ShamrockCircuits/KiCad_Component_DB/OPT/readme.md

OPT - Optoelectronics Component Library

Please check that your device is listed below before adding it to this library.
Check that the component type does not already exist in a different library before adding below.
Consider making an entirely new library before adding a new component type below.

__Supported Component Types__
Opto couplers, Phototransistors, ect

__Do NOT Place These Parts Here__
SSR -> See RLY
LED -> See DIO
