ShamrockCircuits/KiCad_Component_DB/libdb.xlsx

Sheet: Index
Code | Sheet | Database Table (sqlite) | Description | Row Count | LEGEND
ANA | ANA | Analog | Op-amps, Comparators, A/D, D/A | 1 | FORMULA
CAP | CAP | Capacitor | Capacitors | 26
CNT | CNT | Connector | Connectors | 7
CPD | CPD | Protection | Circuit Protection Devices (MOV, Varistor, Fuse, etc) | 0
DIO | DIO | Diode | Diodes (Zener, TVS, LED, Schottky, Standard) | 14
FAB | FAB | Fabrication | Fabrication specific elements (Fiducial, Tooling Holes, Mouse Bites) | 7
ICS | ICS | IntegratedCircuit | General Integrated Circuits | 4
IND | IND | Magnetics | Inductors, Transformers, Chokes, Magnetics | 2
MCU | MCU | Microcontroller | Microcontrollers, Modules, etc. | 1
MEC | MEC | Mechanical | Mechanical components (Mounting holes, etc) | 0
MRK | MRK | Marking | Symbols, Logos and Graphics... ie Non-BOM | 7
OPT | OPT | Optoelectronics | Optocouplers, phototransistor, SSR etc. | 0
OSC | OSC | Oscillator | Oscillators, Crystals | 0
REG | REG | Regulator | Regulators (LDO, Buck, Boost, Flyback, etc) | 2
RES | RES | Resistor | Resistors | 83
RFM | RFM | Radio | RF Modules, ICs, and Related components | 0
RLY | RLY | Relay | Relays, SSR, etc | 3
SEN | SEN | Sensor | Environmental Sensors | 0
SOC | SOC | SystemOnChip | SOC, SOM, SBC, MPU etc. | 0
SWI | SWI | Switch | All Types of Mechanical Switch | 3
TRN | TRN | Transistor | BJT, FET, IGBT | 7

Sheet: ANA
IPN | Description | FLAG - Has Basic Part | Value | Case/Package Size | Type | Symbols | Footprints | Datasheet | MFN_1 | MPN_1 | LCSC_1 | LCSC_TYPE_1 | Status_1 | MFN_2 | MPN_2 | LCSC_2 | LCSC_TYPE_2 | Status_2 | MFN_3 | MPN_3 | LCSC_3 | LCSC_TYPE_3 | Status_3 | MFN_4 | MPN_4 | LCSC_4 | LCSC_TYPE_4 | Status_4 | Comment
ANA-101-0000 | Opamp, GBWP 370kHz, RRO, 10V | FALSE | ANA1010000 | SOT23-5 | Opamp | 0-ANA:SYM-ANA-0000 | 1-PACKAGES:Generic-SOT-23-5 | https://ww1.microchip.com/downloads/en/DeviceDoc/MIC7300-High-Output-Drive-Rail-to-Rail-Op-Amp-DS20006305A.pdf | Microchip | MIC7300YM5_ | C145391 | BASIC | Candidate

Sheet: CAP
IPN | Description | FLAG - Has Basic Part | Value | Capacitance [nF] | Voltage Rating [V] | Type | Dielectric | Tolerance [%] | Case/Package Size | Symbols | Footprints | Datasheet | MFN_1 | MPN_1 | LCSC_1 | LCSC_TYPE_1 | Status_1 | MFN_2 | MPN_2 | LCSC_2 | LCSC_TYPE_2 | Status_2 | MFN_3 | MPN_3 | LCSC_3 | LCSC_TYPE_3 | Status_3 | MFN_4 | MPN_4 | LCSC_4 | LCSC_TYPE_4 | Status_4 | Comment
CAP-000-1042 | Cap Cer 100nF 50V X7R 0603 - BASIC | TRUE | 100n | 100 | 50V | Cer | X7R | 10 | 0603 | 0-CAP:SYM-CAP-0000 | 0-CAP:FTP-CAP-0001 | ~ | Samsung | CC0603KRX7R9BB104 | C14663 | BASIC | Preferred
CAP-001-1032 | Cap Cer 10nF 50V X7R 0402 - BASIC | TRUE | 10n | 10 | 50V | Cer | X7R | 10 | 0402 | 0-CAP:SYM-CAP-0000 | 0-CAP:FTP-CAP-0000 | ~ | Samsung | CL05B103KB5NNNC | C15195 | BASIC | Preferred
CAP-001-1042 | Cap Cer 100nF 50V X7R 0402 - BASIC | TRUE | 100n | 100 | 50V | Cer | X7R | 10 | 0402 | 0-CAP:SYM-CAP-0000 | 0-CAP:FTP-CAP-0000 | ~ | Samsung | CL05B104KB54PNC | C307331 | BASIC | Preferred
CAP-002-1003 | Cap Cer 10pF 50V C0G/NP0 0402 - BASIC | TRUE | 10p | 0.01 | 50V | Cer | C0G/NP0 | 5 | 0402 | 0-CAP:SYM-CAP-0000 | 0-CAP:FTP-CAP-0000 | ~ | Samsung | CL05C100JB5NNNC | C32949 | BASIC | Preferred
CAP-002-1013 | Cap Cer 100pF 50V C0G/NP0 0402 - BASIC | TRUE | 100p | 0.1 | 50V | Cer | C0G/NP0 | 5 | 0402 | 0-CAP:SYM-CAP-0000 | 0-CAP:FTP-CAP-0000 | ~ | FH | 0402CG101J500NT | C1546 | BASIC | Preferred
CAP-002-1203 | Cap Cer 12pF 50V C0G/NP0 0402 - BASIC | TRUE | 12p | 0.012 | 50V | Cer | C0G/NP0 | 5 | 0402 | 0-CAP:SYM-CAP-0000 | 0-CAP:FTP-CAP-0000 | ~ | FH | 0402CG120J500NT | C1547 | BASIC | Preferred
CAP-002-1503 | Cap Cer 15pF 50V C0G/NP0 0402 - BASIC | TRUE | 15p | 0.015 | 50V | Cer | C0G/NP0 | 5 | 0402 | 0-CAP:SYM-CAP-0000 | 0-CAP:FTP-CAP-0000 | ~ | FH | 0402CG150J500NT | C1548 | BASIC | Preferred
CAP-002-1803 | Cap Cer 18pF 50V C0G/NP0 0402 - BASIC | TRUE | 18p | 0.018 | 50V | Cer | C0G/NP0 | 5 | 0402 | 0-CAP:SYM-CAP-0000 | 0-CAP:FTP-CAP-0000 | ~ | FH | 0402CG180J500NT | C1549 | BASIC | Preferred
CAP-002-2003 | Cap Cer 20pF 50V C0G/NP0 0402 - BASIC | TRUE | 20p | 0.02 | 50V | Cer | C0G/NP0 | 5 | 0402 | 0-CAP:SYM-CAP-0000 | 0-CAP:FTP-CAP-0000 | ~ | FH | 0402CG200J500NT | C1554 | BASIC | Preferred
CAP-002-2203 | Cap Cer 22pF 50V C0G/NP0 0402 - BASIC | TRUE | 22p | 0.022 | 50V | Cer | C0G/NP0 | 5 | 0402 | 0-CAP:SYM-CAP-0000 | 0-CAP:FTP-CAP-0000 | ~ | FH | 0402CG220J500NT | C1555 | BASIC | Preferred
CAP-002-2703 | Cap Cer 27pF 50V C0G/NP0 0402 - BASIC | TRUE | 27p | 0.027 | 50V | Cer | C0G/NP0 | 5 | 0402 | 0-CAP:SYM-CAP-0000 | 0-CAP:FTP-CAP-0000 | ~ | FH | 0402CG270J500NT | C1557 | BASIC | Preferred
CAP-002-3303 | Cap Cer 33pF 50V C0G/NP0 0402 - BASIC | TRUE | 33p | 0.033 | 50V | Cer | C0G/NP0 | 5 | 0402 | 0-CAP:SYM-CAP-0000 | 0-CAP:FTP-CAP-0000 | ~ | FH | 0402CG330J500NT | C1562 | BASIC | Preferred
CAP-003-1051 | Cap Cer 1uF 50V X5R 0603 - BASIC | TRUE | 1u | 1000 | 50V | Cer | X5R | 10 | 0603 | 0-CAP:SYM-CAP-0000 | 0-CAP:FTP-CAP-0001 | ~ | Samsung | CL10A105KB8NNNC | C15849 | BASIC | Preferred
CAP-004-2261 | Cap Cer 22uF 6.3V X5R 0603 - BASIC | TRUE | 22u | 22000 | 6.3V | Cer | X5R | 20 | 0603 | 0-CAP:SYM-CAP-0000 | 0-CAP:FTP-CAP-0001 | ~ | Samsung | CL10A226MQ8NRNC | C59461 | BASIC | Preferred
CAP-005-2251 | Cap Cer 2.2uF 16V X5R 0603 - BASIC | TRUE | 2.2u | 2200 | 16V | Cer | X5R | 10 | 0603 | 0-CAP:SYM-CAP-0000 | 0-CAP:FTP-CAP-0001 | ~ | Samsung | CL10A225KO8NNNC | C23630 | BASIC | Preferred
CAP-005-4751 | Cap Cer 4.7uF 16V X5R 0603 - BASIC | TRUE | 4.7u | 4700 | 16V | Cer | X5R | 10 | 0603 | 0-CAP:SYM-CAP-0000 | 0-CAP:FTP-CAP-0001 | ~ | Samsung | CL10A475KO8NNNC | C19666 | BASIC | Preferred
CAP-006-1042 | Cap Cer 100nF 16V X7R 0402 - BASIC | TRUE | 100n | 100 | 16V | Cer | X7R | 10 | 0402 | 0-CAP:SYM-CAP-0000 | 0-CAP:FTP-CAP-0000 | ~ | Samsung | CL05B104KO5NNNC | C1525 | BASIC | Preferred
CAP-006-1061 | Cap Cer 10uF 10V X5R 0603 - BASIC | TRUE | 10u | 10000 | 10V | Cer | X5R | 10 | 0603 | 0-CAP:SYM-CAP-0000 | 0-CAP:FTP-CAP-0001 | ~ | Samsung | CL10A106KP8NNNC | C19702 | BASIC | Preferred
CAP-007-1061 | Cap Cer 10uF 25V X5R 0805 - BASIC | TRUE | 10u | 10000 | 25V | Cer | X5R | 10 | 0805 | 0-CAP:SYM-CAP-0000 | 0-CAP:FTP-CAP-0002 | ~ | Samsung | CL21A106KAYNNNE | C15850 | BASIC | Preferred
CAP-008-2261 | Cap Cer 22uF 25V X5R 0805 | FALSE | 22u | 22000 | 25V | Cer | X5R | 20 | 0805 | 0-CAP:SYM-CAP-0000 | 0-CAP:FTP-CAP-0002 | ~ | Samsung | CL21A226MAQNNNE | C45783 | BASIC | EOL |  |  |  |  |  |  |  |  |  |  |  |  |  |  |  | 11/17/2025 - CL21A226MAQNNNE updated to EOL.
CAP-009-4761 | Cap Cer 47uF 6.3V X5R 0805 - BASIC | TRUE | 47u | 47000 | 6.3V | Cer | X5R | 20 | 0805 | 0-CAP:SYM-CAP-0000 | 0-CAP:FTP-CAP-0002 | ~ | Samsung | CL21A476MQYNNNE | C16780 | BASIC | Preferred
CAP-010-1061 | Cap Cer 10uF 50V X5R 0805 - BASIC | TRUE | 10u | 10000 | 50V | Cer | X5R | 10 | 0805 | 0-CAP:SYM-CAP-0000 | 0-CAP:FTP-CAP-0002 | ~ | Murata | GRM21BR61H106KE43L | C440198 | BASIC | Preferred
CAP-010-2251 | Cap Cer 2.2uF 50V X5R 0805 - BASIC | TRUE | 2.2u | 2200 | 50V | Cer | X5R | 10 | 0805 | 0-CAP:SYM-CAP-0000 | 0-CAP:FTP-CAP-0002 | ~ | Samsung | CL21A225KBQNNNE | C377773 | BASIC | Preferred
CAP-999-0000 | PLACEHOLDER - 0402 | FALSE | TBD | TBD | TBD | Cer | N/A | ~ | 0402 | 0-CAP:SYM-CAP-0000 | 0-CAP:FTP-CAP-0000 | ~
CAP-999-0001 | PLACEHOLDER - 0603 | FALSE | TBD | TBD | TBD | Cer | N/A | ~ | 0603 | 0-CAP:SYM-CAP-0000 | 0-CAP:FTP-CAP-0001 | ~
CAP-999-0002 | PLACEHOLDER - 0805 | FALSE | TBD | TBD | TBD | Cer | N/A | ~ | 0805 | 0-CAP:SYM-CAP-0000 | 0-CAP:FTP-CAP-0002 | ~

Sheet: CNT
IPN | Description | Value | Symbols | Footprints | Datasheet | MFN_1 | MPN_1 | LCSC_1 | LCSC_TYPE_1 | Status_1 | MFN_2 | MPN_2 | LCSC_2 | LCSC_TYPE_2 | Status_2 | MFN_3 | MPN_3 | LCSC_3 | LCSC_TYPE_3 | Status_3 | MFN_4 | MPN_4 | LCSC_4 | LCSC_TYPE_4 | Status_4 | Comment
CNT-112-0000 | 1x02 Pin, Male Socket, Horz, 5.08mm | CNT1120000 | 0-CNT:SYM-CNT-0012 | 0-CNT:FTP-CNT-0000 | https://www.phoenixcontact.com/en-us/products/pcb-header-mstba-25-hc-2-g-508-1923869?type=pdf | Phoenix Contact | 1923869 | C5443585, EXT |  | Preferred
CNT-113-0000 | 1x03 Pin, Male Socket, Horz, 5.08mm | CNT1130000 | 0-CNT:SYM-CNT-0011 | 0-CNT:FTP-CNT-0001 | https://www.phoenixcontact.com/en-ca/products/pcb-header-mstba-25-hc-3-g-508-1923872 | Phoenix Contact | 1923872 | C5484355, EXT |  | Preferred
CNT-114-0000 | 1x04 Pin, Male Socket, Horz, 5.08mm | CNT1140000 | 0-CNT:SYM-CNT-0010 | 0-CNT:FTP-CNT-0002 | https://www.phoenixcontact.com/en-pc/products/pcb-header-mstba-25-hc-4-g-508-1923885 | Phoenix Contact | 1923885 | C6983854, EXT |  | Preferred
CNT-122-0000 | 1x02 Pin, Male Header, Vert, 2.54mm | CNT1220000 | 0-CNT:SYM-CNT-0001 | 0-CNT:FTP-CNT-0007 |  | Molex | 22284020 | C234182, EXT |  | Alternate
CNT-123-0000 | 1x03 Pin, Male Header, Vert, 2.54mm | CNT1230000 | 0-CNT:SYM-CNT-0002 | 0-CNT:FTP-CNT-0008 |  | Molex | 22284030 | C587036, EXT |  | Alternate
CNT-125-0000 | 1x05 Pin, Male Header, Vert, 2.54mm | CNT1250000 | 0-CNT:SYM-CNT-0003 | 0-CNT:FTP-CNT-0010 |  | Molex | 22284050 | C563741, EXT |  | Alternate
CNT-141-0000 | 1 Pin, Drill 1mm, No Component Object | CNT1410000 | 0-CNT:SYM-CNT-0013 | 0-CNT:FTP-CNT-0012 | n/a | n/a | n/a | n/a |  | Preferred

Sheet: CPD
IPN | Auto-Gen Description | Description | Value | Case/Package Size | Type | Symbols | Footprints | Datasheet | MFN_1 | MPN_1 | LCSC_1 | LCSC_TYPE_1 | Status_1 | MFN_2 | MPN_2 | LCSC_2 | LCSC_TYPE_2 | Status_2 | MFN_3 | MPN_3 | LCSC_3 | LCSC_TYPE_3 | Status_3 | MFN_4 | MPN_4 | LCSC_4 | LCSC_TYPE_4 | Status_4 | Comment

Sheet: DIO
IPN | Description | Value | Vfd @10mA [V] | DC Current [A] | Reverse Voltage [V] | Power Dissipation [W] | Case/Package Size | Type | Other... | Symbols | Footprints | Datasheet | MFN_1 | MPN_1 | LCSC_1 | LCSC_TYPE_1 | Status_1 | MFN_2 | MPN_2 | LCSC_2 | LCSC_TYPE_2 | Status_2 | MFN_3 | MPN_3 | LCSC_3 | LCSC_TYPE_3 | Status_3 | MFN_4 | MPN_4 | LCSC_4 | LCSC_TYPE_4 | Status_4 | Comment
DIO-021-0000 | DIO Standard 100VR SOT23-3 - BASIC | DIO0210000 | 0.855 | 0.125 | 100 | 0.25 | SOT23-3 | Standard |  | 0-DIO:SYM-DIO-0005 | 1-PACKAGES:Generic-SOT-23-3 | ~ | Nexperia | BAV99,215 | C2500, BASIC |  | Preferred
DIO-021-0001 | DIO Standard 100.0VR SOD-323 - BASIC | DIO0210001 | 0.855 | 0.15 | 100 | 0.2 | SOD-323 | Standard |  | 0-DIO:SYM-DIO-0004 | 0-DIO:FTP-DIO-0003 | ~ | JCST | 1N4148WS | C2128, BASIC |  | Preferred
DIO-099-9999 | TBD | DIO0999999 | ~ | ~ | ~ | ~ | ~ | Standard | ~ | 0-DIO:SYM-DIO-0004 | ~ | ~ | ~ | ~ | ~ |  | Banned
DIO-311-0000 | DIO TVS 3.3VRWM SOD-523 | DIO3110000 | ~ | ~ | 3.3 | ~ | SOD-523 | TVS | Vrwm=3.3V, Vbr=7.0V, Vhold=1.15V, Ihold=20mA, IPP=5A@8/20us, IEC61000-4-2 15kV (air & contact) | 0-DIO:SYM-DIO-0001 | 0-DIO:FTP-DIO-0002 | ~ | Onsemi | ESD8351XV2T_G | C233437, EXT |  | Preferred |  |  |  |  |  |  |  |  |  |  |  |  |  |  |  | 07/12/2025: Beware risk of latchup due to crowbar response.
DIO-321-0000 | DIO TVS 5.0VRWM SOD-123W | DIO3210000 | ~ | ~ | 5 | 200PP | SOD-123W | TVS | Vrwm=5.0V, Vbr=7.0V, IR=800uA | 0-DIO:SYM-DIO-0001 | 0-DIO:FTP-DIO-0004 | ~ | Nexperia | PTVS5V0S1UR,115 | C478011, EXT |  | Preferred | Taiwan Semiconductor | SMF5.0A |  | n/a | Alternate
DIO-321-0001 | DIO TVS 5.0VR SOD-323 | DIO3210001 | ~ | ~ | 5 | 350PP | SOD-323 | TVS | Vrwm=5.0V, Vbr=xxV, IR=10uA | 0-DIO:SYM-DIO-0001 | 0-DIO:FTP-DIO-0003 | ~ | Bourns | CDSOD323-T05S | C3699212, EXT |  | Preferred | Onsemi | SD05T3G |  | C896890 | Candidate
DIO-361-0000 | DIO BI-TVS 26.0VR DO-214AC | DIO3610000 | ~ | ~ | 26 | 400PP | DO-214AC | TVS | Bidirectional, Vrwm=28V, Vbr=28.9V @32mA, Vhold=1.15V, IPP=9.5A, 42.1V @8/20us | 0-DIO:SYM-DIO-0002 | 0-DIO:FTP-DIO-0005 | https://www.littelfuse.com/assetdocs/tvs-diodes-smaj-datasheet?assetguid=13c2a823-03b8-4d1f-9ddc-9b44670aed9d | Littlefuse | SMAJ26CA* | C148228, EXT |  | Preferred
DIO-401-0000 | DIO LED 5.0VR 0603 WHT - BASIC | WHT | 2.9 | 0.03 | 5 | 0.1 | 0603 | LED | Color=WHT | 0-DIO:SYM-DIO-0000 | 0-DIO:FTP-DIO-0000 | ~ | Hubei | KT-0603W | C2290, BASIC |  | Preferred
DIO-401-0001 | DIO LED 5.0VR 0805 WHT - BASIC | WHT | 2.9 | 0.025 | 5 | 0.08 | 0805 | LED | Color=WHT | 0-DIO:SYM-DIO-0000 | 0-DIO:FTP-DIO-0001 | ~ | Hubei | KT-0805W | C34499, BASIC |  | Preferred
DIO-411-0000 | DIO LED 5.0VR 0603 RED - BASIC | RED | 1.9 | 0.025 | 5 | 0.04 | 0603 | LED | λ=620nm, Color=RED | 0-DIO:SYM-DIO-0000 | 0-DIO:FTP-DIO-0000 | ~ | Hubei | KT-0603R | C2286, BASIC |  | Preferred
DIO-421-0001 | DIO LED 5.0VR 0805 GRN - BASIC | GRN | 2 | 0.02 | 5 | 0.04 | 0805 | LED | λ=520nm, Color=GRN | 0-DIO:SYM-DIO-0000 | 0-DIO:FTP-DIO-0001 | ~ | Hubei | KT-0805G | C2297, BASIC |  | Preferred
DIO-431-0000 | DIO LED 5.0VR 0603 BLU | BLU | 3 | 0.025 | 5 | 0.075 | 0603 | LED | λ=470nm, Color=BLU | 0-DIO:SYM-DIO-0000 | 0-DIO:FTP-DIO-0000 | ~ | Hubei | KT-0603B | C2288, EXT |  | Preferred
DIO-441-0000 | DIO LED 5.0VR 0603 YLW | YLW | 2 | 0.025 | 5 | 0.04 | 0603 | LED | λ=590nm, Color=YLW | 0-DIO:SYM-DIO-0000 | 0-DIO:FTP-DIO-0000 | ~ | Hubei | KT-0603Y | C2287, EXT |  | Preferred
DIO-441-0001 | DIO LED 5.0VR 0805 YLW - BASIC | YLW | 2 | 0.02 | 5 | 0.04 | 0805 | LED | λ=590nm, Color=YLW | 0-DIO:SYM-DIO-0000 | 0-DIO:FTP-DIO-0001 | ~ | Hubei | KT-0805Y | C2296, BASIC |  | Preferred

Sheet: FAB
IPN | Description | Value | Symbols | Footprints | Datasheet | MFN_1 | MPN_1 | LCSC_1 | LCSC_TYPE_1 | Status_1 | MFN_2 | MPN_2 | LCSC_2 | LCSC_TYPE_2 | Status_2 | MFN_3 | MPN_3 | LCSC_3 | LCSC_TYPE_3 | Status_3 | MFN_4 | MPN_4 | LCSC_4 | LCSC_TYPE_4 | Status_4 | Comment
FAB-000-0000 | SMD Solder Jumper, 0.5x1.7mm, 0.2mm gap, Open | FAB0000000 | 0-FAB:SYM-FAB-0000 | 0-FAB:FTP-FAB-0000 | ~ | ~ | ~ | ~ |  | Preferred
FAB-100-0000 | Fiducial. 1mm CU, 2mm SM, JLC | FAB0030000 | 0-FAB:SYM-FAB-0005 | 0-FAB:FTP-FAB-0005 | ~ | ~ | ~ | ~ |  | Preferred
FAB-200-0000 | Tooling Hole, 1.152mm NPTH, JLCPCB | FAB0020000 | 0-FAB:SYM-FAB-0004 | 0-FAB:FTP-FAB-0004 | ~ | ~ | ~ | ~ |  | Preferred
FAB-400-0000 | Oscilloscope Probe, Test Point, w/ Ground, 5mm | FAB4000000 | 0-FAB:SYM-FAB-0001 | 0-FAB:FTP-FAB-0001 | ~ | ~ | ~ | ~ |  | Preferred
FAB-400-0001 | Oscilloscope Probe, Test Point, w/ Ground, 3mm | FAB4000001 | 0-FAB:SYM-FAB-0001 | 0-FAB:FTP-FAB-0002 | ~ | ~ | ~ | ~ |  | Preferred
FAB-400-0002 | Probe, Test Point, Keystone 5001 - Black | FAB4000002 | 0-FAB:SYM-FAB-0003 | 0-FAB:FTP-FAB-0003a | ~ | Ronghe | RH-5001 | C5199801, EXT |  | Preferred | Keystone | 5001 |  | C238122, EXT | Alternate
FAB-400-0003 | Probe, Test Point, Keystone 5000 - Red | FAB4000003 | 0-FAB:SYM-FAB-0003 | 0-FAB:FTP-FAB-0003b | ~ | Ronghe | RH-5000 | C5277086, EXT |  | Preferred | Keystone | 5000 |  | C5277086, EXT | Alternate

Sheet: ICS
IPN | Auto-Gen Description | Description | Value | Case/Package Size | Type | Symbols | Footprints | Datasheet | MFN_1 | MPN_1 | LCSC_1 | LCSC_TYPE_1 | Status_1 | MFN_2 | MPN_2 | LCSC_2 | LCSC_TYPE_2 | Status_2 | MFN_3 | MPN_3 | LCSC_3 | LCSC_TYPE_3 | Status_3 | MFN_4 | MPN_4 | LCSC_4 | LCSC_TYPE_4 | Status_4 | Comment
ICS-000-0000 |  | Quad Tri-State Buffer, 2.5ns RT, TSSOP-14 | ICS0000000 | TSSOP-14 (4.40mm) | Tri-State Buffer | 0-ICS:SYM-ICS-0000 | 1-PACKAGES:Generic-TSSOP-14_4.4x5mm_P0.65mm | https://assets.nexperia.com/documents/data-sheet/74LVC125A.pdf | Nexperia | 74LVC125APW,118 | C6059, EXT |  | Preferred
ICS-000-0001 |  | Single Tri-State Buffer, 3ns RT, TSSOP-5 | ICS0000001 | SOT-353 | Tri-State Buffer | 0-ICS:SYM-ICS-0001 | 1-PACKAGES:Generic-SOT-353_SC-70-5 | https://assets.nexperia.com/documents/data-sheet/74LVC1G125.pdf | Nexperia | 74LVC1G125GW,125 | C12519, EXT |  | Preferred
ICS-001-0000 |  | Quad Nand Gate, 2 Input, 2.5ns RT, SOIC-14 | ICS0010000 | SOIC-14 (3.90mm) | Logic, NAND | 0-ICS:SYM-ICS-0002 | 1-PACKAGES:Generic-SOIC-14_3.9x8.7mm_P1.27mm | https://assets.nexperia.com/documents/data-sheet/74ALVC00.pdf | Nexperia | 74ALVC00D,118 | N/A |  | Preferred
ICS-002-0000 |  | Logic Level Translator | ICS0020000 | TSSOP-24 (4.40mm) | Logic Level Translator | 0-ICS:SYM-ICS-0003 | 1-PACKAGES:Generic-TSSOP-24_4.4x7.8mm_P0.65mm.kicad_mod | https://assets.nexperia.com/documents/data-sheet/74LVC4245A.pdf | Nexperia | 74LVC4245APW,118 | C6091, EXT |  | Preferred

Sheet: IND
IPN | Description | Value | Imax [A] | DCR [mΩ] | Case/Package Size | Type | Symbols | Footprints | Datasheet | MFN_1 | MPN_1 | LCSC_1 | LCSC_TYPE_1 | Status_1 | MFN_2 | MPN_2 | LCSC_2 | LCSC_TYPE_2 | Status_2 | MFN_3 | MPN_3 | LCSC_3 | LCSC_TYPE_3 | Status_3 | MFN_4 | MPN_4 | LCSC_4 | LCSC_TYPE_4 | Status_4 | Comment
IND-000-2204 | Ind, Power 22uH 0.76A 350mΩ 4.0x4.0 | 22u | 0.76 | 350 | 4.0x4.0 | Ind, Power | 0-IND:SYM-IND-0001 | 0-IND:FTP-IND-0000 | https://mm.digikey.com/Volume0/opasdata/d220001/medias/docus/610/NRS4018T220MDGJ_SS.pdf | Taiyo Yuden | NRS4018T220MDGJ | C222884, EXT |  | Preferred | Pulse Electronics | BWVS00404018220M00 |  | N/A | Candidate
IND-001-4703 | Ind, Power 4.7uH 1.2A 160mΩ 3.0x3.0 | 4.7u | 1.2 | 160 | 3.0x3.0 | Ind, Power | 0-IND:SYM-IND-0001 | 0-IND:FTP-IND-0001 | https://mm.digikey.com/Volume0/opasdata/d220001/medias/docus/610/NRH3012T4R7MN_SS.pdf | Taiyo Yuden | NRH3012T4R7MN | C92955, EXT |  | Preferred | TDK | VLS3012CX-4R7M-1 |  | C2047716, EXT | Candidate

Sheet: MCU
IPN | Description | Value | Case/Package Size | Symbols | Footprints | Datasheet | MFN_1 | MPN_1 | LCSC_1 | LCSC_TYPE_1 | Status_1 | MFN_2 | MPN_2 | LCSC_2 | LCSC_TYPE_2 | Status_2 | MFN_3 | MPN_3 | LCSC_3 | LCSC_TYPE_3 | Status_3 | MFN_4 | MPN_4 | LCSC_4 | LCSC_TYPE_4 | Status_4 | Comment
MCU-000-0000 | ATTINY1616 - 20MHz, 16kB Flash, 2kB SRAM, 256B EEPROM, VQFN-20 | ATTINY1616-MN_ | VQFN-24 | 0-MCU:SYM-MCU-0000 | 1-PACKAGES:Generic-VQFN-20-1EP_3x3mm_P0.4mm_EP1.7x1.7mm | https://ww1.microchip.com/downloads/en/DeviceDoc/ATtiny1614-16-17-DataSheet-DS40002204A.pdf | Microchip | ATtiny1617-MN_ | C507118, EXT |  | Preferred

Sheet: MEC
IPN | Auto-Gen Description | Description | Value | Case/Package Size | Type | Symbols | Footprints | Datasheet | MFN_1 | MPN_1 | LCSC_1 | LCSC_TYPE_1 | Status_1 | MFN_2 | MPN_2 | LCSC_2 | LCSC_TYPE_2 | Status_2 | MFN_3 | MPN_3 | LCSC_3 | LCSC_TYPE_3 | Status_3 | MFN_4 | MPN_4 | LCSC_4 | LCSC_TYPE_4 | Status_4 | Comment

Sheet: MRK
IPN | Auto-Gen Description | Description | Value | Case/Package Size | Type | Symbols | Footprints | Datasheet | MFN_1 | MPN_1 | LCSC_1 | LCSC_TYPE_1 | Status_1 | MFN_2 | MPN_2 | LCSC_2 | LCSC_TYPE_2 | Status_2 | MFN_3 | MPN_3 | LCSC_3 | LCSC_TYPE_3 | Status_3 | MFN_4 | MPN_4 | LCSC_4 | LCSC_TYPE_4 | Status_4 | Comment
MRK-000-0000 |  | Shamrock Circuits Logo - Medium | ~ | ~ | ~ | 0-MRK:SYM-MRK-0000 | 0-MRK:FTP-MRK-0000 | ~ | ~ | ~ | ~ |  | Preferred
MRK-000-0001 |  | Shamrock Circuits Logo - Small | ~ | ~ | ~ | 0-MRK:SYM-MRK-0000 | 0-MRK:FTP-MRK-0001 | ~ | ~ | ~ | ~ |  | Preferred
MRK-001-0000 |  | JLCJLCJLC | ~ | ~ | ~ | 0-MRK:SYM-MRK-0002 | 0-MRK:FTP-MRK-0003 | ~ | ~ | ~ | ~ |  | Preferred
MRK-002-0000 |  | Serial Number - Small | ~ | ~ | ~ | 0-MRK:SYM-MRK-0001 | 0-MRK:FTP-MRK-0002b | ~ | ~ | ~ | ~ |  | Preferred
MRK-002-0001 |  | Serial Number - Medium | ~ | ~ | ~ | 0-MRK:SYM-MRK-0001 | 0-MRK:FTP-MRK-0002a | ~ | ~ | ~ | ~ |  | Preferred
MRK-003-0000 |  | Quality Check - Small | ~ | ~ | ~ | 0-MRK:SYM-MRK-0003 | 0-MRK:FTP-MRK-0004a | ~ | ~ | ~ | ~ |  | Preferred
MRK-003-0001 |  | Quality Check - Medium | ~ | ~ | ~ | 0-MRK:SYM-MRK-0003 | 0-MRK:FTP-MRK-0004b | ~ | ~ | ~ | ~ |  | Preferred

Sheet: OPT
IPN | Auto-Gen Description | Description | Value | Case/Package Size | Type | Symbols | Footprints | Datasheet | MFN_1 | MPN_1 | LCSC_1 | LCSC_TYPE_1 | Status_1 | MFN_2 | MPN_2 | LCSC_2 | LCSC_TYPE_2 | Status_2 | MFN_3 | MPN_3 | LCSC_3 | LCSC_TYPE_3 | Status_3 | MFN_4 | MPN_4 | LCSC_4 | LCSC_TYPE_4 | Status_4 | Comment

Sheet: OSC
IPN | Auto-Gen Description | Description | Value | Case/Package Size | Type | Symbols | Footprints | Datasheet | MFN_1 | MPN_1 | LCSC_1 | LCSC_TYPE_1 | Status_1 | MFN_2 | MPN_2 | LCSC_2 | LCSC_TYPE_2 | Status_2 | MFN_3 | MPN_3 | LCSC_3 | LCSC_TYPE_3 | Status_3 | MFN_4 | MPN_4 | LCSC_4 | LCSC_TYPE_4 | Status_4 | Comment

Sheet: REG
IPN | Auto-Gen Description | Description | Value | Type | Case/Package Size | Other... | Symbols | Footprints | Datasheet | MFN_1 | MPN_1 | LCSC_1 | LCSC_TYPE_1 | Status_1 | MFN_2 | MPN_2 | LCSC_2 | LCSC_TYPE_2 | Status_2 | MFN_3 | MPN_3 | LCSC_3 | LCSC_TYPE_3 | Status_3 | MFN_4 | MPN_4 | LCSC_4 | LCSC_TYPE_4 | Status_4 | Comment
REG-121-0000 |  | Boost type Adjustable 3.3V~28V 1.8V~5.5V SOT-23-6 DC-DC | REG1210000 | BOOST | SOT23-6 |  | 0-REG:SYM-REG-0000 | 1-PACKAGES:Generic-SOT23-6 | https://www.ti.com/lit/ds/symlink/tlv61046a.pdf?ts=1752317963415 | Texas Instruments | TLV61046ADBV* | C464815, BASIC |  | Preferred | Analog Devices | LT3461 |  | ??? | Candidate | Analog Devices |  | LTC3400 | ??? | Candidate
REG-991-0000 |  | Boost Converter with Battery Management for Energy Harvester (Solar) | BQ25504RG | ENERGY HARVEST | VQFN-16 | Vin_min=0.6V, Vin_max=3V, Vbat_min=2.5V, Vbat_max=5.25V | 0-REG:SYM-REG-0001 | 1-PACKAGES:Generic-VQFN-16-1EP_3x3mm_P0.5mm_EP1.68x1.68mm | https://www.ti.com/lit/ds/symlink/bq25504.pdf?ts=1752276394083 | Texas Instruments | BQ25504RGT* | C2876746, BASIC |  | Preferred

Sheet: RES
IPN | Description | Value | Power Rating [W] | Type | TCR [ppm/K] | Tolerance [%] | Case/Package Size | Symbols | Footprints | Datasheet | MFN_1 | MPN_1 | LCSC_1 | LCSC_TYPE_1 | Status_1 | MFN_2 | MPN_2 | LCSC_2 | LCSC_TYPE_2 | Status_2 | MFN_3 | MPN_3 | LCSC_3 | LCSC_TYPE_3 | Status_3 | MFN_4 | MPN_4 | LCSC_4 | LCSC_TYPE_4 | Status_4 | Comment
RES-000-0000 | RES ThickF 0Ω ±1% 0.1W 0603 - BASIC | 0 | 0.1 | ThickF | 200 | 1 | 0603 | 0-RES:SYM-RES-0000 | 0-RES:FTP-RES-0001 | ~ | UNI-ROYAL | 0603WAF0000T5E | C21189, BASIC |  | Preferred |  |  |  |  |  |  |  |  |  |  |  |  |  |  |  | 07/08/2025: Tolerance spec is placeholder, MPN_1 is poorly documented.
RES-000-1000 | RES ThickF 1Ω ±1% 0.1W 0603 - BASIC | 1 | 0.1 | ThickF | 200 | 1 | 0603 | 0-RES:SYM-RES-0000 | 0-RES:FTP-RES-0001 | ~ | UNI-ROYAL | 0603WAF100KT5E | C22936, BASIC |  | Preferred
RES-000-1001 | RES ThickF 10Ω ±1% 0.1W 0603 - BASIC | 10 | 0.1 | ThickF | 200 | 1 | 0603 | 0-RES:SYM-RES-0000 | 0-RES:FTP-RES-0001 | ~ | UNI-ROYAL | 0603WAF100JT5E | C22859, BASIC |  | Preferred
RES-000-1002 | RES ThickF 100Ω ±1% 0.1W 0603 - BASIC | 100 | 0.1 | ThickF | 200 | 1 | 0603 | 0-RES:SYM-RES-0000 | 0-RES:FTP-RES-0001 | ~ | UNI-ROYAL | 0603WAF1000T5E | C22775, BASIC |  | Preferred
RES-000-1003 | RES ThickF 1kΩ ±1% 0.1W 0603 - BASIC | 1k | 0.1 | ThickF | 200 | 1 | 0603 | 0-RES:SYM-RES-0000 | 0-RES:FTP-RES-0001 | ~ | UNI-ROYAL | 0603WAF1001T5E | C21190, BASIC |  | Preferred
RES-000-1004 | RES ThickF 10kΩ ±1% 0.1W 0603 - BASIC | 10k | 0.1 | ThickF | 200 | 1 | 0603 | 0-RES:SYM-RES-0000 | 0-RES:FTP-RES-0001 | ~ | UNI-ROYAL | 0603WAF1002T5E | C25804, BASIC |  | Preferred
RES-000-1005 | RES ThickF 100kΩ ±1% 0.1W 0603 - BASIC | 100k | 0.1 | ThickF | 200 | 1 | 0603 | 0-RES:SYM-RES-0000 | 0-RES:FTP-RES-0001 | ~ | UNI-ROYAL | 0603WAF1003T5E | C25803, BASIC |  | Preferred
RES-000-1006 | RES ThickF 1MΩ ±1% 0.1W 0603 - BASIC | 1M | 0.1 | ThickF | 200 | 1 | 0603 | 0-RES:SYM-RES-0000 | 0-RES:FTP-RES-0001 | ~ | UNI-ROYAL | 0603WAF1004T5E | C22935, BASIC |  | Preferred
RES-000-1007 | RES ThickF 10MΩ ±1% 0.1W 0603 - BASIC | 10M | 0.1 | ThickF | 200 | 1 | 0603 | 0-RES:SYM-RES-0000 | 0-RES:FTP-RES-0001 | ~ | UNI-ROYAL | 0603WAF1005T5E | C7250, BASIC |  | Preferred
RES-000-1651 | RES ThickF 16.5Ω ±1% 0.1W 0603 | 16.5 | 0.1 | ThickF | 200 | 1 | 0603 | 0-RES:SYM-RES-0000 | 0-RES:FTP-RES-0001 | ~ | UNI-ROYAL | 0603WAF165JT5E | C12054, EXT |  | Preferred
RES-000-2006 | RES ThickF 2MΩ ±1% 0.1W 0603 - BASIC | 2M | 0.1 | ThickF | 200 | 1 | 0603 | 0-RES:SYM-RES-0000 | 0-RES:FTP-RES-0001 | ~ | UNI-ROYAL | 0603WAF2004T5E | C22976, BASIC |  | Preferred
RES-000-2200 | RES ThickF 2.2Ω ±1% 0.1W 0603 - BASIC | 2.2 | 0.1 | ThickF | 200 | 1 | 0603 | 0-RES:SYM-RES-0000 | 0-RES:FTP-RES-0001 | ~ | UNI-ROYAL | 0603WAF220KT5E | C22939, BASIC |  | Preferred
RES-000-2201 | RES ThickF 22Ω ±1% 0.1W 0603 - BASIC | 22 | 0.1 | ThickF | 200 | 1 | 0603 | 0-RES:SYM-RES-0000 | 0-RES:FTP-RES-0001 | ~ | UNI-ROYAL | 0603WAF220JT5E | C23345, BASIC |  | Preferred
RES-000-2202 | RES ThickF 220Ω ±1% 0.1W 0603 - BASIC | 220 | 0.1 | ThickF | 200 | 1 | 0603 | 0-RES:SYM-RES-0000 | 0-RES:FTP-RES-0001 | ~ | UNI-ROYAL | 0603WAF2200T5E | C22962, BASIC |  | Preferred
RES-000-2203 | RES ThickF 2.2kΩ ±1% 0.1W 0603 - BASIC | 2.2k | 0.1 | ThickF | 200 | 1 | 0603 | 0-RES:SYM-RES-0000 | 0-RES:FTP-RES-0001 | ~ | UNI-ROYAL | 0603WAF2201T5E | C4190, BASIC |  | Preferred
RES-000-2204 | RES ThickF 22kΩ ±1% 0.1W 0603 - BASIC | 22k | 0.1 | ThickF | 200 | 1 | 0603 | 0-RES:SYM-RES-0000 | 0-RES:FTP-RES-0001 | ~ | UNI-ROYAL | 0603WAF2202T5E | C31850, BASIC |  | Preferred
RES-000-2205 | RES ThickF 220kΩ ±1% 0.1W 0603 - BASIC | 220k | 0.1 | ThickF | 200 | 1 | 0603 | 0-RES:SYM-RES-0000 | 0-RES:FTP-RES-0001 | ~ | UNI-ROYAL | 0603WAF2203T5E | C22961, BASIC |  | Preferred
RES-000-2702 | RES ThickF 270Ω ±1% 0.1W 0603 - BASIC | 270 | 0.1 | ThickF | 200 | 1 | 0603 | 0-RES:SYM-RES-0000 | 0-RES:FTP-RES-0001 | ~ | UNI-ROYAL | 0603WAF2700T5E | C22966, BASIC |  | Preferred
RES-000-3301 | RES ThickF 33Ω ±1% 0.1W 0603 - BASIC | 33 | 0.1 | ThickF | 200 | 1 | 0603 | 0-RES:SYM-RES-0000 | 0-RES:FTP-RES-0001 | ~ | UNI-ROYAL | 0603WAF330JT5E | C23140, BASIC |  | Preferred
RES-000-3302 | RES ThickF 330Ω ±1% 0.1W 0603 - BASIC | 330 | 0.1 | ThickF | 200 | 1 | 0603 | 0-RES:SYM-RES-0000 | 0-RES:FTP-RES-0001 | ~ | UNI-ROYAL | 0603WAF3300T5E | C23138, BASIC |  | Preferred
RES-000-3303 | RES ThickF 3.3kΩ ±1% 0.1W 0603 - BASIC | 3.3k | 0.1 | ThickF | 200 | 1 | 0603 | 0-RES:SYM-RES-0000 | 0-RES:FTP-RES-0001 | ~ | UNI-ROYAL | 0603WAF3301T5E | C22978, BASIC |  | Preferred
RES-000-3304 | RES ThickF 33kΩ ±1% 0.1W 0603 - BASIC | 33k | 0.1 | ThickF | 200 | 1 | 0603 | 0-RES:SYM-RES-0000 | 0-RES:FTP-RES-0001 | ~ | UNI-ROYAL | 0603WAF3302T5E | C4216, BASIC |  | Preferred
RES-000-3305 | RES ThickF 330kΩ ±1% 0.1W 0603 - BASIC | 330k | 0.1 | ThickF | 200 | 1 | 0603 | 0-RES:SYM-RES-0000 | 0-RES:FTP-RES-0001 | ~ | UNI-ROYAL | 0603WAF3303T5E | C23137, BASIC |  | Preferred
RES-000-4700 | RES ThickF 4.7Ω ±1% 0.1W 0603 - BASIC | 4.7 | 0.1 | ThickF | 200 | 1 | 0603 | 0-RES:SYM-RES-0000 | 0-RES:FTP-RES-0001 | ~ | UNI-ROYAL | 0603WAF470KT5E | C23164, BASIC |  | Preferred
RES-000-4701 | RES ThickF 47Ω ±1% 0.1W 0603 - BASIC | 47 | 0.1 | ThickF | 200 | 1 | 0603 | 0-RES:SYM-RES-0000 | 0-RES:FTP-RES-0001 | ~ | UNI-ROYAL | 0603WAF470JT5E | C23182, BASIC |  | Preferred
RES-000-4702 | RES ThickF 470Ω ±1% 0.1W 0603 - BASIC | 470 | 0.1 | ThickF | 200 | 1 | 0603 | 0-RES:SYM-RES-0000 | 0-RES:FTP-RES-0001 | ~ | UNI-ROYAL | 0603WAF4700T5E | C23179, BASIC |  | Preferred
RES-000-4703 | RES ThickF 4.7kΩ ±1% 0.1W 0603 - BASIC | 4.7k | 0.1 | ThickF | 200 | 1 | 0603 | 0-RES:SYM-RES-0000 | 0-RES:FTP-RES-0001 | ~ | UNI-ROYAL | 0603WAF4701T5E | C23162, BASIC |  | Preferred
RES-000-4705 | RES ThickF 470kΩ ±1% 0.1W 0603 - BASIC | 470k | 0.1 | ThickF | 200 | 1 | 0603 | 0-RES:SYM-RES-0000 | 0-RES:FTP-RES-0001 | ~ | UNI-ROYAL | 0603WAF4703T5E | C23178, BASIC |  | Preferred
RES-000-4991 | RES ThickF 49.9Ω ±1% 0.1W 0603 - BASIC | 49.9 | 0.1 | ThickF | 200 | 1 | 0603 | 0-RES:SYM-RES-0000 | 0-RES:FTP-RES-0001 | ~ | UNI-ROYAL | 0603WAF499JT5E | C23185, BASIC |  | Preferred | Stackpole Electronics Inc | RMCF0603FT49R9 |  |  | Preferred
RES-000-5366 | RES ThickF 5.36MΩ ±1% 0.1W 0603 | 5.36M | 0.1 | ThickF | 200 | 1 | 0603 | 0-RES:SYM-RES-0000 | 0-RES:FTP-RES-0001 | ~ | UNI-ROYAL | 0603WAF5364T5E | C422919, EXT |  | Preferred
RES-000-5602 | RES ThickF 560Ω ±1% 0.1W 0603 - BASIC | 560 | 0.1 | ThickF | 200 | 1 | 0603 | 0-RES:SYM-RES-0000 | 0-RES:FTP-RES-0001 | ~ | UNI-ROYAL | 0603WAF5600T5E | C23204, BASIC |  | Preferred
RES-000-5603 | RES ThickF 5.6kΩ ±1% 0.1W 0603 - BASIC | 5.6k | 0.1 | ThickF | 200 | 1 | 0603 | 0-RES:SYM-RES-0000 | 0-RES:FTP-RES-0001 | ~ | UNI-ROYAL | 0603WAF5601T5E | C23189, BASIC |  | Preferred
RES-000-5604 | RES ThickF 56kΩ ±1% 0.1W 0603 - BASIC | 56k | 0.1 | ThickF | 200 | 1 | 0603 | 0-RES:SYM-RES-0000 | 0-RES:FTP-RES-0001 | ~ | UNI-ROYAL | 0603WAF5602T5E | C23206, BASIC |  | Preferred
RES-000-6206 | RES ThickF 6.2MΩ ±1% 0.1W 0603 | 6.2M | 0.1 | ThickF | 200 | 1 | 0603 | 0-RES:SYM-RES-0000 | 0-RES:FTP-RES-0001 | ~ | UNI-ROYAL | 0603WAF6204T5E | C54536, EXT |  | Preferred
RES-000-6802 | RES ThickF 680Ω ±1% 0.1W 0603 - BASIC | 680 | 0.1 | ThickF | 200 | 1 | 0603 | 0-RES:SYM-RES-0000 | 0-RES:FTP-RES-0001 | ~ | UNI-ROYAL | 0603WAF6800T5E | C23228, BASIC |  | Preferred
RES-000-6804 | RES ThickF 68kΩ ±1% 0.1W 0603 - BASIC | 68k | 0.1 | ThickF | 200 | 1 | 0603 | 0-RES:SYM-RES-0000 | 0-RES:FTP-RES-0001 | ~ | UNI-ROYAL | 0603WAF6802T5E | C23231, BASIC |  | Preferred
RES-000-7501 | RES ThickF 75Ω ±1% 0.1W 0603 - BASIC | 75 | 0.1 | ThickF | 200 | 1 | 0603 | 0-RES:SYM-RES-0000 | 0-RES:FTP-RES-0001 | ~ | UNI-ROYAL | 0603WAF750JT5E | C4275, BASIC |  | Preferred
RES-001-0000 | RES ThickF 0Ω ±1% 0.0625W 0402 - BASIC | 0 | 0.0625 | ThickF | 200 | 1 | 0402 | 0-RES:SYM-RES-0000 | 0-RES:FTP-RES-0000 | ~ | UNI-ROYAL | 0402WGF0000TCE | C17168, BASIC |  | Preferred
RES-001-1001 | RES ThickF 10Ω ±1% 0.0625W 0402 - BASIC | 10 | 0.0625 | ThickF | 200 | 1 | 0402 | 0-RES:SYM-RES-0000 | 0-RES:FTP-RES-0000 | ~ | UNI-ROYAL | 0402WGF100JTCE | C25077, BASIC |  | Preferred
RES-001-1002 | RES ThickF 100Ω ±1% 0.0625W 0402 - BASIC | 100 | 0.0625 | ThickF | 200 | 1 | 0402 | 0-RES:SYM-RES-0000 | 0-RES:FTP-RES-0000 | ~ | UNI-ROYAL | 0402WGF1000TCE | C25076, BASIC |  | Preferred
RES-001-1003 | RES ThickF 1kΩ ±1% 0.0625W 0402 - BASIC | 1k | 0.0625 | ThickF | 200 | 1 | 0402 | 0-RES:SYM-RES-0000 | 0-RES:FTP-RES-0000 | ~ | UNI-ROYAL | 0402WGF1001TCE | C11702, BASIC |  | Preferred
RES-001-1004 | RES ThickF 10kΩ ±1% 0.0625W 0402 - BASIC | 10k | 0.0625 | ThickF | 200 | 1 | 0402 | 0-RES:SYM-RES-0000 | 0-RES:FTP-RES-0000 | ~ | UNI-ROYAL | 0402WGF1002TCE | C25744, BASIC |  | Preferred
RES-001-1005 | RES ThickF 100kΩ ±1% 0.0625W 0402 - BASIC | 100k | 0.0625 | ThickF | 200 | 1 | 0402 | 0-RES:SYM-RES-0000 | 0-RES:FTP-RES-0000 | ~ | UNI-ROYAL | 0402WGF1003TCE | C25741, BASIC |  | Preferred
RES-001-1006 | RES ThickF 1MΩ ±1% 0.0625W 0402 - BASIC | 1M | 0.0625 | ThickF | 200 | 1 | 0402 | 0-RES:SYM-RES-0000 | 0-RES:FTP-RES-0000 | ~ | UNI-ROYAL | 0402WGF1004TCE | C26083, BASIC |  | Preferred
RES-001-1007 | RES ThickF 10MΩ ±1% 0.0625W 0402 - BASIC | 10M | 0.0625 | ThickF | 200 | 1 | 0402 | 0-RES:SYM-RES-0000 | 0-RES:FTP-RES-0000 | ~ | UNI-ROYAL | 0402WGF1005TCE | C26082, EXT |  | Preferred
RES-001-1202 | RES ThickF 120Ω ±1% 0.0625W 0402 - BASIC | 120 | 0.0625 | ThickF | 200 | 1 | 0402 | 0-RES:SYM-RES-0000 | 0-RES:FTP-RES-0000 | ~ | UNI-ROYAL | 0402WGF1200TCE | C25079, BASIC |  | Preferred
RES-001-1304 | RES ThickF 13kΩ ±1% 0.0625W 0402 | 13k | 0.0625 | ThickF | 200 | 1 | 0402 | 0-RES:SYM-RES-0000 | 0-RES:FTP-RES-0000 | ~ | UNI-ROYAL | 0402WGF1302TCE | C25754, EXT |  | Preferred
RES-001-1697 | RES ThickF 16.9MΩ ±1% 0.0625W 0402 | 16.9M | 0.0625 | ThickF | 200 | 1 | 0402 | 0-RES:SYM-RES-0000 | 0-RES:FTP-RES-0000 | ~ | UNI-ROYAL | 0402WGF1695TCE | C423225, EXT |  | Preferred
RES-001-2002 | RES ThickF 200Ω ±1% 0.0625W 0402 - BASIC | 200 | 0.0625 | ThickF | 200 | 1 | 0402 | 0-RES:SYM-RES-0000 | 0-RES:FTP-RES-0000 | ~ | UNI-ROYAL | 0402WGF2000TCE | C25087, BASIC |  | Preferred
RES-001-2003 | RES ThickF 2kΩ ±1% 0.0625W 0402 - BASIC | 2k | 0.0625 | ThickF | 200 | 1 | 0402 | 0-RES:SYM-RES-0000 | 0-RES:FTP-RES-0000 | ~ | UNI-ROYAL | 0402WGF2001TCE | C4109, BASIC |  | Preferred
RES-001-2005 | RES ThickF 200kΩ ±1% 0.0625W 0402 - BASIC | 200k | 0.0625 | ThickF | 200 | 1 | 0402 | 0-RES:SYM-RES-0000 | 0-RES:FTP-RES-0000 | ~ | UNI-ROYAL | 0402WGF2003TCE | C25764, BASIC |  | Preferred
RES-001-2201 | RES ThickF 22Ω ±1% 0.0625W 0402 - BASIC | 22 | 0.0625 | ThickF | 200 | 1 | 0402 | 0-RES:SYM-RES-0000 | 0-RES:FTP-RES-0000 | ~ | UNI-ROYAL | 0402WGF220JTCE | C25092, BASIC |  | Preferred
RES-001-2202 | RES ThickF 220Ω ±1% 0.0625W 0402 - BASIC | 220 | 0.0625 | ThickF | 200 | 1 | 0402 | 0-RES:SYM-RES-0000 | 0-RES:FTP-RES-0000 | ~ | UNI-ROYAL | 0402WGF2200TCE | C25091, BASIC |  | Preferred
RES-001-2203 | RES ThickF 2.2kΩ ±1% 0.0625W 0402 - BASIC | 2.2k | 0.0625 | ThickF | 200 | 1 | 0402 | 0-RES:SYM-RES-0000 | 0-RES:FTP-RES-0000 | ~ | UNI-ROYAL | 0402WGF2201TCE | C25879, BASIC |  | Preferred
RES-001-2204 | RES ThickF 22kΩ ±1% 0.0625W 0402 - BASIC | 22k | 0.0625 | ThickF | 200 | 1 | 0402 | 0-RES:SYM-RES-0000 | 0-RES:FTP-RES-0000 | ~ | UNI-ROYAL | 0402WGF2202TCE | C25768, BASIC |  | Preferred
RES-001-2494 | RES ThickF 24.9KΩ ±1% 0.0625W 0402 | 24.9K | 0.0625 | ThickF | 200 | 1 | 0402 | 0-RES:SYM-RES-0000 | 0-RES:FTP-RES-0000 | ` | UNI-ROYAL | 0402WGF2492TCE | C25874, EXT |  | Preferred
RES-001-2705 | RES ThickF 270kΩ ±1% 0.0625W 0402 | 270k | 0.0625 | ThickF | 200 | 1 | 0402 | 0-RES:SYM-RES-0000 | 0-RES:FTP-RES-0000 | ~ | YAGEO | RC0402FR-07270KL | C163475, EXT |  | Preferred
RES-001-3301 | RES ThickF 33Ω ±1% 0.0625W 0402 - BASIC | 33 | 0.0625 | ThickF | 200 | 1 | 0402 | 0-RES:SYM-RES-0000 | 0-RES:FTP-RES-0000 | ~ | UNI-ROYAL | 0402WGF330JTCE | C25105, BASIC |  | Preferred
RES-001-3302 | RES ThickF 330Ω ±1% 0.0625W 0402 | 330 | 0.0625 | ThickF | 200 | 1 | 0402 | 0-RES:SYM-RES-0000 | 0-RES:FTP-RES-0000 | ~ | UNI-ROYAL | 0402WGF3300TCE | C25104, BASIC |  | Preferred
RES-001-3303 | RES ThickF 3.3kΩ ±1% 0.0625W 0402 - BASIC | 3.3k | 0.0625 | ThickF | 200 | 1 | 0402 | 0-RES:SYM-RES-0000 | 0-RES:FTP-RES-0000 | ~ | UNI-ROYAL | 0402WGF3301TCE | C25890, BASIC |  | Preferred
RES-001-3304 | RES ThickF 33kΩ ±1% 0.0625W 0402 - BASIC | 33k | 0.0625 | ThickF | 200 | 1 | 0402 | 0-RES:SYM-RES-0000 | 0-RES:FTP-RES-0000 | ~ | UNI-ROYAL | 0402WGF3302TCE | C25779, BASIC |  | Preferred
RES-001-3606 | RES ThickF 3.6MΩ ±1% 0.0625W 0402 | 3.6M | 0.0625 | ThickF | 200 | 1 | 0402 | 0-RES:SYM-RES-0000 | 0-RES:FTP-RES-0000 | ~ | UNI-ROYAL | 0402WGF3604TCE | C423182, EXT |  | Preferred
RES-001-4026 | RES ThickF 4.02MΩ ±1% 0.0625W 0402 | 4.02M | 0.0625 | ThickF | 200 | 1 | 0402 | 0-RES:SYM-RES-0000 | 0-RES:FTP-RES-0000 | ~ | UNI-ROYAL | 0402WGF4024TCE | C423177, EXT |  | Preferred
RES-001-4646 | RES ThickF 4.64MΩ ±1% 0.0625W 0402 | 4.64M | 0.0625 | ThickF | 200 | 1 | 0402 | 0-RES:SYM-RES-0000 | 0-RES:FTP-RES-0000 | ~ | UNI-ROYAL | 0402WGF4644TCE | C423165, EXT |  | Preferred
RES-001-4702 | RES ThickF 470Ω ±1% 0.0625W 0402 - BASIC | 470 | 0.0625 | ThickF | 200 | 1 | 0402 | 0-RES:SYM-RES-0000 | 0-RES:FTP-RES-0000 | ~ | UNI-ROYAL | 0402WGF4700TCE | C25117, BASIC |  | Preferred
RES-001-4703 | RES ThickF 4.7kΩ ±1% 0.0625W 0402 - BASIC | 4.7k | 0.0625 | ThickF | 200 | 1 | 0402 | 0-RES:SYM-RES-0000 | 0-RES:FTP-RES-0000 | ~ | UNI-ROYAL | 0402WGF4701TCE | C25900, BASIC |  | Preferred
RES-001-4704 | RES ThickF 47kΩ ±1% 0.0625W 0402 - BASIC | 47k | 0.0625 | ThickF | 200 | 1 | 0402 | 0-RES:SYM-RES-0000 | 0-RES:FTP-RES-0000 | ~ | UNI-ROYAL | 0402WGF4702TCE | C25792, BASIC |  | Preferred
RES-001-4991 | RES ThickF 49.9Ω ±1% 0.0625W 0402 - BASIC | 49.9 | 0.0625 | ThickF | 200 | 1 | 0402 | 0-RES:SYM-RES-0000 | 0-RES:FTP-RES-0000 | ~ | UNI-ROYAL | 0402WGF499JTCE | C25120, BASIC |  | Preferred
RES-001-5605 | RES ThickF 560kΩ ±1% 0.0625W 0402 | 560k | 0.0625 | ThickF | 200 | 1 | 0402 | 0-RES:SYM-RES-0000 | 0-RES:FTP-RES-0000 | ~ | UNI-ROYAL | 0402WGF5603TCE | C132339, EXT |  | Preferred
RES-001-6496 | RES ThickF 6.49MΩ ±1% 0.0625W 0402 | 6.49M | 0.0625 | ThickF | 200 | 1 | 0402 | 0-RES:SYM-RES-0000 | 0-RES:FTP-RES-0000 | ~ | UNI-ROYAL | 0402WGF6494TCE | C38588, EXT |  | Preferred
RES-002-1002 | RES Pot 100Ω 0.1W, Vertical | 100 | 0.1 | Pot | 999 | 0 | ~ | 0-RES:SYM-RES-0001 | 0-RES:FTP-RES-0003 | ~ | KYOCERA AVX | 601010 | N/A |  | Preferred |  |  |  |  |  |  |  |  |  |  |  |  |  |  |  | 8/17/2025: Jelly bean THT potentiometer. Se also RM065 kits.
RES-003-2700 | RES ThickF 2.7Ω ±1% 0.125W 0805 | 2.7 | 0.125 | ThickF | 200 | 1 | 0805 | 0-RES:SYM-RES-0000 | 0-RES:FTP-RES-0002 | ~ | Stackpole Electronics | RMCF0805FT2R70 | C4101419, EXT |  | Preferred | UNI-ROYAL | 0805W8F270KT5E |  | C17532, EXT |  |  |  |  |  |  |  |  |  |  |  | 12/13/2025: Changed RES-003 to 200ppm to make it more crossable.
RES-003-6800 | RES ThickF 6.8Ω ±1% 0.125W 0805 - BASIC | 6.8 | 0.125 | ThickF | 200 | 1 | 0805 | 0-RES:SYM-RES-0000 | 0-RES:FTP-RES-0002 | ~ | YAGEO | RC0805FR-076R8L | C137492, EXT |  | Preferred
RES-004-0010 | RES ThickF 0.1Ω ±1% 0.25W 1206 - BASIC | 0.1 | 0.25 | ThickF | 800 | 1 | 1206 | 0-RES:SYM-RES-0000 | 0-RES:FTP-RES-0004 | ~ | UNI-ROYAL | 1206W4F100LT5E | C25334, BASIC |  | Preferred
RES-005-3656 | RES ThickF 3.65MΩ ±1% 0.1W 0603 | 3.65M | 0.1 | ThickF | 100 | 1 | 0603 | 0-RES:SYM-RES-0000 | 0-RES:FTP-RES-0001 | ~ | UNI-ROYAL | 0603WAF3654T5E | C407525, EXT |  | Preferred | YAGEO | RC0603FR-073M65L |  | C482835, EXT
RES-005-3906 | RES ThickF 3.9MΩ ±1% 0.1W 0603 | 3.9M | 0.1 | ThickF | 100 | 1 | 0603 | 0-RES:SYM-RES-0000 | 0-RES:FTP-RES-0001 | ~ | UNI-ROYAL | 0603WAF3904T5E | C23019, EXT |  | Preferred
RES-005-4656 | RES ThickF 4.64MΩ ±1% 0.1W 0603 | 4.64M | 0.1 | ThickF | 100 | 1 | 0603 | 0-RES:SYM-RES-0000 | 0-RES:FTP-RES-0001 | ~ | UNI-ROYAL | 0603WAF4644T5E | C422925, EXT |  | Preferred | YAGEO | RC0603FR-074M64L |  | C482862, EXT
RES-005-5366 | RES ThickF 5.36MΩ ±1% 0.1W 0603 | 5.36M | 0.1 | ThickF | 100 | 1 | 0603 | 0-RES:SYM-RES-0000 | 0-RES:FTP-RES-0001 | ~ | UNI-ROYAL | 0603WAF5364T5E | C422919, EXT |  | Preferred | YAGEO | RC0603FR-075M36L |  | C482876, EXT
RES-005-5626 | RES ThickF 5.62MΩ ±1% 0.1W 0603 | 5.62M | 0.1 | ThickF | 100 | 1 | 0603 | 0-RES:SYM-RES-0000 | 0-RES:FTP-RES-0001 | ~ | UNI-ROYAL | 0603WAF5624T5E | C422916, EXT |  | Preferred | YAGEO | RC0603FR-075M62L |  | C482880, EXT
RES-005-5906 | RES ThickF 5.9MΩ ±1% 0.1W 0603 | 5.9M | 0.1 | ThickF | 100 | 1 | 0603 | 0-RES:SYM-RES-0000 | 0-RES:FTP-RES-0001 | ~ | UNI-ROYAL | 0603WAF5904T5E | C422915, EXT |  | Preferred
RES-999-0000 | PLACEHOLDER - 0603 | TBD | ~ | ThickF | ~ | ~ | 0603 | 0-RES:SYM-RES-0000 | 0-RES:FTP-RES-0001 | ~ | ~ | ~ | ~ |  | Banned
RES-999-0001 | PLACEHOLDER - 0805 | TBD | ~ | ThickF | ~ | ~ | 0805 | 0-RES:SYM-RES-0000 | 0-RES:FTP-RES-0002 | ~ | ~ | ~ | ~ |  | Banned
RES-999-0002 | PLACEHOLDER - 0402 | TBD | ~ | ThickF | ~ | ~ | 0402 | 0-RES:SYM-RES-0000 | 0-RES:FTP-RES-0000 | ~ | ~ | ~ | ~ |  | Banned

Sheet: RFM
IPN | Auto-Gen Description | Description | Value | Case/Package Size | Type | Symbols | Footprints | Datasheet | MFN_1 | MPN_1 | LCSC_1 | LCSC_TYPE_1 | Status_1 | MFN_2 | MPN_2 | LCSC_2 | LCSC_TYPE_2 | Status_2 | MFN_3 | MPN_3 | LCSC_3 | LCSC_TYPE_3 | Status_3 | MFN_4 | MPN_4 | LCSC_4 | LCSC_TYPE_4 | Status_4 | Comment

Sheet: RLY
IPN | Auto-Gen Description | Description | Value | Case/Package Size | Type | Symbols | Footprints | Datasheet | MFN_1 | MPN_1 | LCSC_1 | LCSC_TYPE_1 | Status_1 | MFN_2 | MPN_2 | LCSC_2 | LCSC_TYPE_2 | Status_2 | MFN_3 | MPN_3 | LCSC_3 | LCSC_TYPE_3 | Status_3 | MFN_4 | MPN_4 | LCSC_4 | LCSC_TYPE_4 | Status_4 | Comment
RLY-000-0000 |  | Automotive Relay Socket | RLY0000000 | ~ |  | 0-RLY:SYM-REL-0000 | 0-RLY:FTP-RLY-0001 | https://www.citrelay.com/wp-content/uploads/2025/08/Sockets.pdf | CIT | HD-1003 | C5729356 |  | Candidate |  |  |  |  |  |  |  |  |  |  |  |  |  |  |  | 11/9/2025: Beware untested footprint. Not aligned with JLC.
RLY-001-0000 |  | HV Relay Socket - 3PDT | RLY0010000 | ~ |  | 0-RLY:SYM-REL-0001 | 0-RLY:FTP-RLY-0000 | https://assets.omron.com/m/6826d5f838b1df29/original/MJN-Datasheet.pdf | OMRON | PTFPCB | C1524944 |  | Candidate
RLY-001-0001 |  | HV Relay Socket - 2PDT | RLY0010001 | ~ |  | 0-RLY:SYM-REL-0002 | 0-RLY:FTP-RLY-0000 | https://assets.omron.com/m/6826d5f838b1df29/original/MJN-Datasheet.pdf | OMRON | PTFPCB | C1524944 |  | Candidate |  |  |  |  |  |  |  |  |  |  |  |  |  |  |  | 11/9/2025 Only for DPDT MJN-series relays.

Sheet: SEN
IPN | Auto-Gen Description | Description | Value | Case/Package Size | Type | Symbols | Footprints | Datasheet | MFN_1 | MPN_1 | LCSC_1 | LCSC_TYPE_1 | Status_1 | MFN_2 | MPN_2 | LCSC_2 | LCSC_TYPE_2 | Status_2 | MFN_3 | MPN_3 | LCSC_3 | LCSC_TYPE_3 | Status_3 | MFN_4 | MPN_4 | LCSC_4 | LCSC_TYPE_4 | Status_4 | Comment

Sheet: SOC
IPN | Auto-Gen Description | Description | Value | Case/Package Size | Type | Symbols | Footprints | Datasheet | MFN_1 | MPN_1 | LCSC_1 | LCSC_TYPE_1 | Status_1 | MFN_2 | MPN_2 | LCSC_2 | LCSC_TYPE_2 | Status_2 | MFN_3 | MPN_3 | LCSC_3 | LCSC_TYPE_3 | Status_3 | MFN_4 | MPN_4 | LCSC_4 | LCSC_TYPE_4 | Status_4 | Comment

Sheet: SWI
IPN | Auto-Gen Description | Description | Value | Case/Package Size | Type | Symbols | Footprints | Datasheet | MFN_1 | MPN_1 | LCSC_1 | LCSC_TYPE_1 | Status_1 | MFN_2 | MPN_2 | LCSC_TYPE_2 | LCSC_2 | Status_2 | MFN_3 | LCSC_TYPE_3 | MPN_3 | LCSC_3 | Status_3 | LCSC_TYPE_4 | MFN_4 | MPN_4 | LCSC_4 | Status_4 | Comment
SWI-101-0000 |  | Tactile Switch, Top-actuated Model | SWI1010000 | 5.00x3.00 | SPST | 0-SWI:SYM-SWI-0000 | 0-SWI:FTP-SWI-0000 | ~ | XUNPU | TS-1088-AR02016 | C720477, BASIC |  | Preferred | CIT | CS1213AGF160 |  | C6768543, EXT | Candidate |  |  |  |  |  |  |  |  |  |  | 7/12/2025: Need to triple check the footprint before release.
SWI-222-0000 |  | Dip Switch, Vertical, 2Pos | SWI2220000 | ~ | SPST | 0-SWI:SYM-SWI-0002 | 0-SWI:FTP-SWI-0002 | https://www.sameskydevices.com/product/resource/ds01-254.pdf | SAME SKY | DS01-254-L-02BE | N/A |  | Candidate
SWI-226-0000 |  | Dip Switch, Vertical, 6Pos | SWI2260000 | ~ | SPST | 0-SWI:SYM-SWI-0001 | 0-SWI:FTP-SWI-0001 | https://www.sameskydevices.com/product/resource/ds01-254.pdf | SAME SKY | DS01C-254-S-06BE | N/A |  | Candidate

Sheet: TRN
IPN | Auto-Gen Description | Description | Value | Case/Package Size | Type | Symbols | Footprints | Datasheet | MFN_1 | MPN_1 | LCSC_1 | LCSC_TYPE_1 | Status_1 | MFN_2 | MPN_2 | LCSC_TYPE_2 | LCSC_2 | Status_2 | MFN_3 | LCSC_TYPE_3 | MPN_3 | LCSC_3 | Status_3 | LCSC_TYPE_4 | MFN_4 | MPN_4 | LCSC_4 | Status_4 | Comment
TRN-000-0000 |  | BJT NPN, 45Vce, 0.6A, hfe ~160 @0.1A | TRN0000000 | SOT23-3 | BJT | 0-TRN:SYM-TRN-0002 | 1-PACKAGES:Generic-SOT-23-3 | https://assets.nexperia.com/documents/data-sheet/BCW66X_SER.pdf | Nexperia | BCW66G* | C549643, EXT |  | Preferred | Onsemi | BCW66G* |  | C165612, EXT | Candidate
TRN-000-9999 |  | BJT, NPN, TBD | TRN0009999 | ~ | BJT | 0-TRN:SYM-TRN-0002 | ~ | Placeholder | ~ | ~ | ~ |  | Banned
TRN-010-0000 |  | NMOS 30Vds 5.7A 1.4W SOT-23-3 | TRN0100000 | SOT23-3 | MOSFET | 0-TRN:SYM-TRN-0000 | 1-PACKAGES:Generic-SOT-23-3 | https://mm.digikey.com/Volume0/opasdata/d220001/medias/docus/1133/AO3400A_ds.pdf | Alpha & Omega | AO3400A | C20917, BASIC |  | Preferred |  |  |  |  |  |  |  |  |  |  |  |  |  |  |  | 7/12/2025: MPN_1 is NRND, lots of similar parts available. Will need to add sources later.
TRN-010-9999 |  | MOSFET, NMOS, TBD | TRN0109999 | ~ | MOSFET | 0-TRN:SYM-TRN-0000 | ~ |  | ~ | ~ | ~ |  | Banned
TRN-011-0000 |  | PMOS -20Vds 8Vgs SOT23-3 3.1A | TRN0110000 | SOT23-3 | MOSFET | 0-TRN:SYM-TRN-0001 | 1-PACKAGES:Generic-SOT-23-3 | https://www.vishay.com/docs/72066/si2301bds.pdf | Vishay | Si2301BDS-T1-*E3 | C10487, BASIC |  | Preferred
TRN-011-0001 |  | PMOS -30Vds 4A 1.4W SOT-23-3 | TRN0110001 | SOT23-3 | MOSFET | 0-TRN:SYM-TRN-0001 | 1-PACKAGES:Generic-SOT-23-3 | https://www.aosmd.com/sites/default/files/res/datasheets/AO3401A.pdf | Alpha & Omega | AO3401A | C15127, BASIC |  | Preferred
TRN-011-9999 |  | MOSFET, PMOS, TBD | TRN0119999 | ~ | MOSFET | 0-TRN:SYM-TRN-0001 | ~ |  | ~ | ~ | ~ |  | Banned

Sheet: _enum
ana_techno |  | cap_dielectric |  | cap_techno |  | dio_techno |  | ics_techno |  | ind_techno |  | mfn |  | mount_type |  | package |  | reg_techno |  | res_techno |  | status |  | trn_techno |  | lcsc_type
Name | Description | name | description | name | description | name | description | name | description | name | description | name | description | name | description | Name | Alternate Name | name | description | name | description | name | description | name | description | name | description
ADC | Analog to digital converter | C0G/NP0 |  | AlumElec | Aluminum Electrolytic | LED | Light emitting diode. | Logic Level Translator |  | Choke |  | Alpha & Omega |  | SCREW |  | 0402 |  | BOOST | Switching step up converter. | Pot | Potentiometer | Alternate | Tested and approved alternate. | BJT | Bipolar Junction FET | BASIC
Comp | Comparator | X5R |  | AlumPoly | Aluminum Polymer | Schottky | Semiconductor-metal junction. Low Vfd, and fast recovery. | Logic, AND |  | Ferrite Bead | Ferrite bead used for filtering. | Analog Devices |  | SMD |  | 0603 |  | BUCK | Switching step down converter. | ThickF | Thick Film | Banned | Not compatible, but may be very similar. Could be used if other HW modifications were made to the circuit. | IGBT | Insulated Gate Bipolar Transistor | EXTENDED | JLCPCB charges extra fee.
DAC | Digital to analog converter | X7R |  | Cer | Ceramic | Standard | Generic silicon diode. | Logic, NAND |  | Ind, Power | Power inductor. | Bourns |  | THT |  | 0805 |  | BUCK-BOOST | Switching converter, step up and down. | ThinF | Thin Film | Candidate | Untested alternate, but seems like a good part. | JFET | Junction Field Effect Transistor
Opamp | Operational amplifier | N/A |  | SuperCap | SuperCapacitor | TVS | Transient voltage suppression diode. | Logic, XOR |  | Ind, Small Signal | Air core inductor used for signal conditioning. | CIT |  |  |  | 1206 |  | ENERGY HARVEST | Any IC seeking to harvest energy. Solar cells ect. | Wire | Wire Wound | EOL | End of life or obsolete | MOSFET | Metal Oxide Semiconductor Field Effect Transistor
 |  |  |  | Tant | Tantalum | Zener |  | Loigc, OR |  | XFRM | Transformer | FH |  |  |  | 1210 |  | LDO | Linear Voltage Regulator |  |  | Preferred | Preferred part to use.
 |  |  |  |  |  |  |  | Tri-State Buffer |  |  |  | Hubei |  |  |  | 1812
 |  |  |  |  |  |  |  |  |  |  |  | JCST |  |  |  | 2010
 |  |  |  |  |  |  |  |  |  |  |  | KYOCERA AVX |  |  |  | 2512
 |  |  |  |  |  |  |  |  |  |  |  | Keystone |  |  |  | 3.0x3.0
 |  |  |  |  |  |  |  |  |  |  |  | Littlefuse |  |  |  | 4.0x4.0
 |  |  |  |  |  |  |  |  |  |  |  | Microchip |  |  |  | DO-214AC | SMA
 |  |  |  |  |  |  |  |  |  |  |  | Molex |  |  |  | SOD-123W
 |  |  |  |  |  |  |  |  |  |  |  | Murata |  |  |  | SOD-323 | SC-76
 |  |  |  |  |  |  |  |  |  |  |  | Nexperia |  |  |  | SOD-523
 |  |  |  |  |  |  |  |  |  |  |  | OMRON |  |  |  | SOIC-14 (3.90mm)
 |  |  |  |  |  |  |  |  |  |  |  | Onsemi |  |  |  | SOT-353 | 5-TSSOP, SC-70-5, SOT-353
 |  |  |  |  |  |  |  |  |  |  |  | Phoenix Contact |  |  |  | SOT23-3
 |  |  |  |  |  |  |  |  |  |  |  | Pulse Electronics |  |  |  | SOT23-5 | SC-74A, SOT-753
 |  |  |  |  |  |  |  |  |  |  |  | Ronghe |  |  |  | SOT23-6
 |  |  |  |  |  |  |  |  |  |  |  | SAME SKY |  |  |  | TSSOP-14 (4.40mm)
 |  |  |  |  |  |  |  |  |  |  |  | Samsung |  |  |  | TSSOP-24 (4.40mm)
 |  |  |  |  |  |  |  |  |  |  |  | Stackpole Electronics |  |  |  | VQFN-16
 |  |  |  |  |  |  |  |  |  |  |  | Stackpole Electronics Inc |  |  |  | VQFN-24
 |  |  |  |  |  |  |  |  |  |  |  | TDK |  |  |  | ~
 |  |  |  |  |  |  |  |  |  |  |  | Taiwan Semiconductor
 |  |  |  |  |  |  |  |  |  |  |  | Taiyo Yuden
 |  |  |  |  |  |  |  |  |  |  |  | Texas Instruments
 |  |  |  |  |  |  |  |  |  |  |  | UNI-ROYAL
 |  |  |  |  |  |  |  |  |  |  |  | Vishay
 |  |  |  |  |  |  |  |  |  |  |  | XUNPU
 |  |  |  |  |  |  |  |  |  |  |  | YAGEO
