ShamrockCircuits/KiCad_Component_DB/FAB/FAB.step/Keystone_5003.STEP

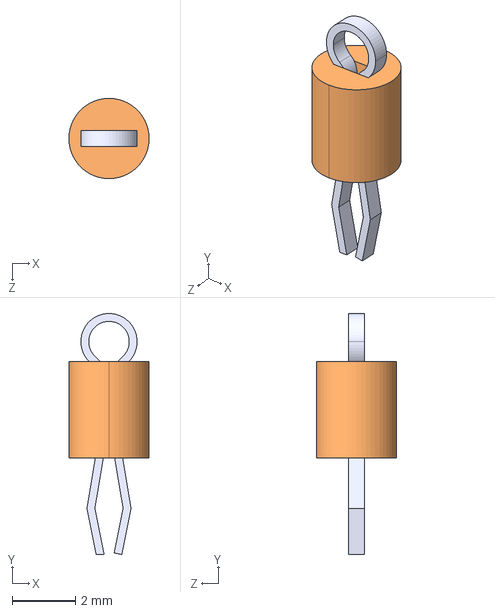
[picture p1: CAD file, 2025-12-14]
FAB/FAB.step/Keystone_5003.STEP
2.54 x 7.62 x 2.54 mm
