ShamrockCircuits/KiCad_Component_DB/RES/RES.step/Runtron_RM065.stp

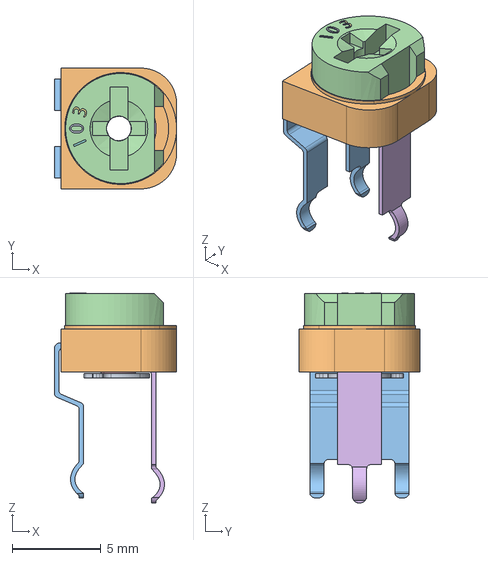
[picture p2: CAD file, 2025-08-19]
RES/RES.step/Runtron_RM065.stp
6.88 x 6.80 x 11.8 mm
