ShamrockCircuits/KiCad_Component_DB/RLY/RLY.step/Automotive_Relay_Mini_Tab.STEP

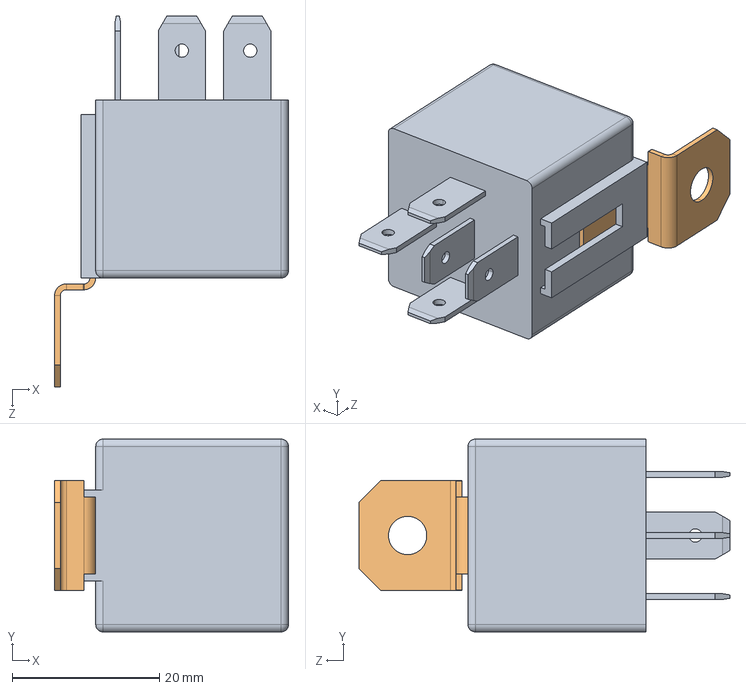
[picture p3: CAD file, 2025-11-13]
RLY/RLY.step/Automotive_Relay_Mini_Tab.STEP
31.8 x 26.2 x 50.4 mm
Relay
Relay holder
