ShamrockCircuits/KiCad_Component_DB/(list of files, cad)

Other CAD files:
FAB/FAB.step/Keystone_5001.STEP
