ShamrockCircuits/KiCad_Component_DB/(commit log)

2025-07-07 General Update
    - Still developing and tweaking the backbone
    - Defining naming schemes for resistor and capacitors
2025-07-17 General Update #3
    Many many changes
    [jlcpcb_basic_parts.xlsx]
2025-08-08 Add MPN and MFN to kicad import.
2025-08-17 Mass Rename and Refactor
    [Keystone_5001.STEP, _template_compare_.xlsx, jlcpcb_basic_parts.xlsx]
2025-08-19 Massive Push
    Worked too much, changed too many things
    I'll be good now promise ;)
    [Runtron_RM065.stp]
2025-08-19 Add FAB-001-0001
    Oscilloscope test point 3mm
2025-08-27 Move TP to FAB folder
    [Keystone_5001.STEP]
2025-08-27 Rename Part. Standardize footprint.
2025-08-28 Correct connector footprint
2025-10-23 Update libdb.kicad_dbl
    Add IPN to export
2025-11-09 Add gitkeep to protect folder structure
    Can't git commit empty folders.... didn't know that.
    KiCad needs all these folders to already exist despite them being empty.
2025-11-13 Create some relays
    [Automotive_Relay_Mini_Tab.STEP]
2025-11-18 Multiple new connector symbols
2025-11-18 Add rules for connectors
2025-11-20 New Connectors Added.
2025-12-01 Fix SYM-SWI-0000 pin numbers
2025-12-01 Create new TVS diode
2025-12-14 Move "K" silkscreen
2025-12-14 Rename footprint and create variant FTP-FAB-0003a/b
2025-12-14 Update - Exclude from BOM, and pos file
2025-12-14 Update exclude from BOM and pos file
2025-12-14 Change pin numbers/names
2026-07-19 New footprints for VFD project
2026-07-20 Save Win11 and Linux version of kicad_dbl
2026-11-05 Remove pin number on SYM-FAB-0003
2026-11-08 Modified Silkscreen
    I wanted to make it cleared that both PTH were part of the TP.
